aesirkth/Mjollnir_flightcontroller_v2/designs/flight_controller/main_controller2.kicad_pcb

## KiCad design designs/flight_controller/main_controller2.kicad_pcb (2023-04-16)

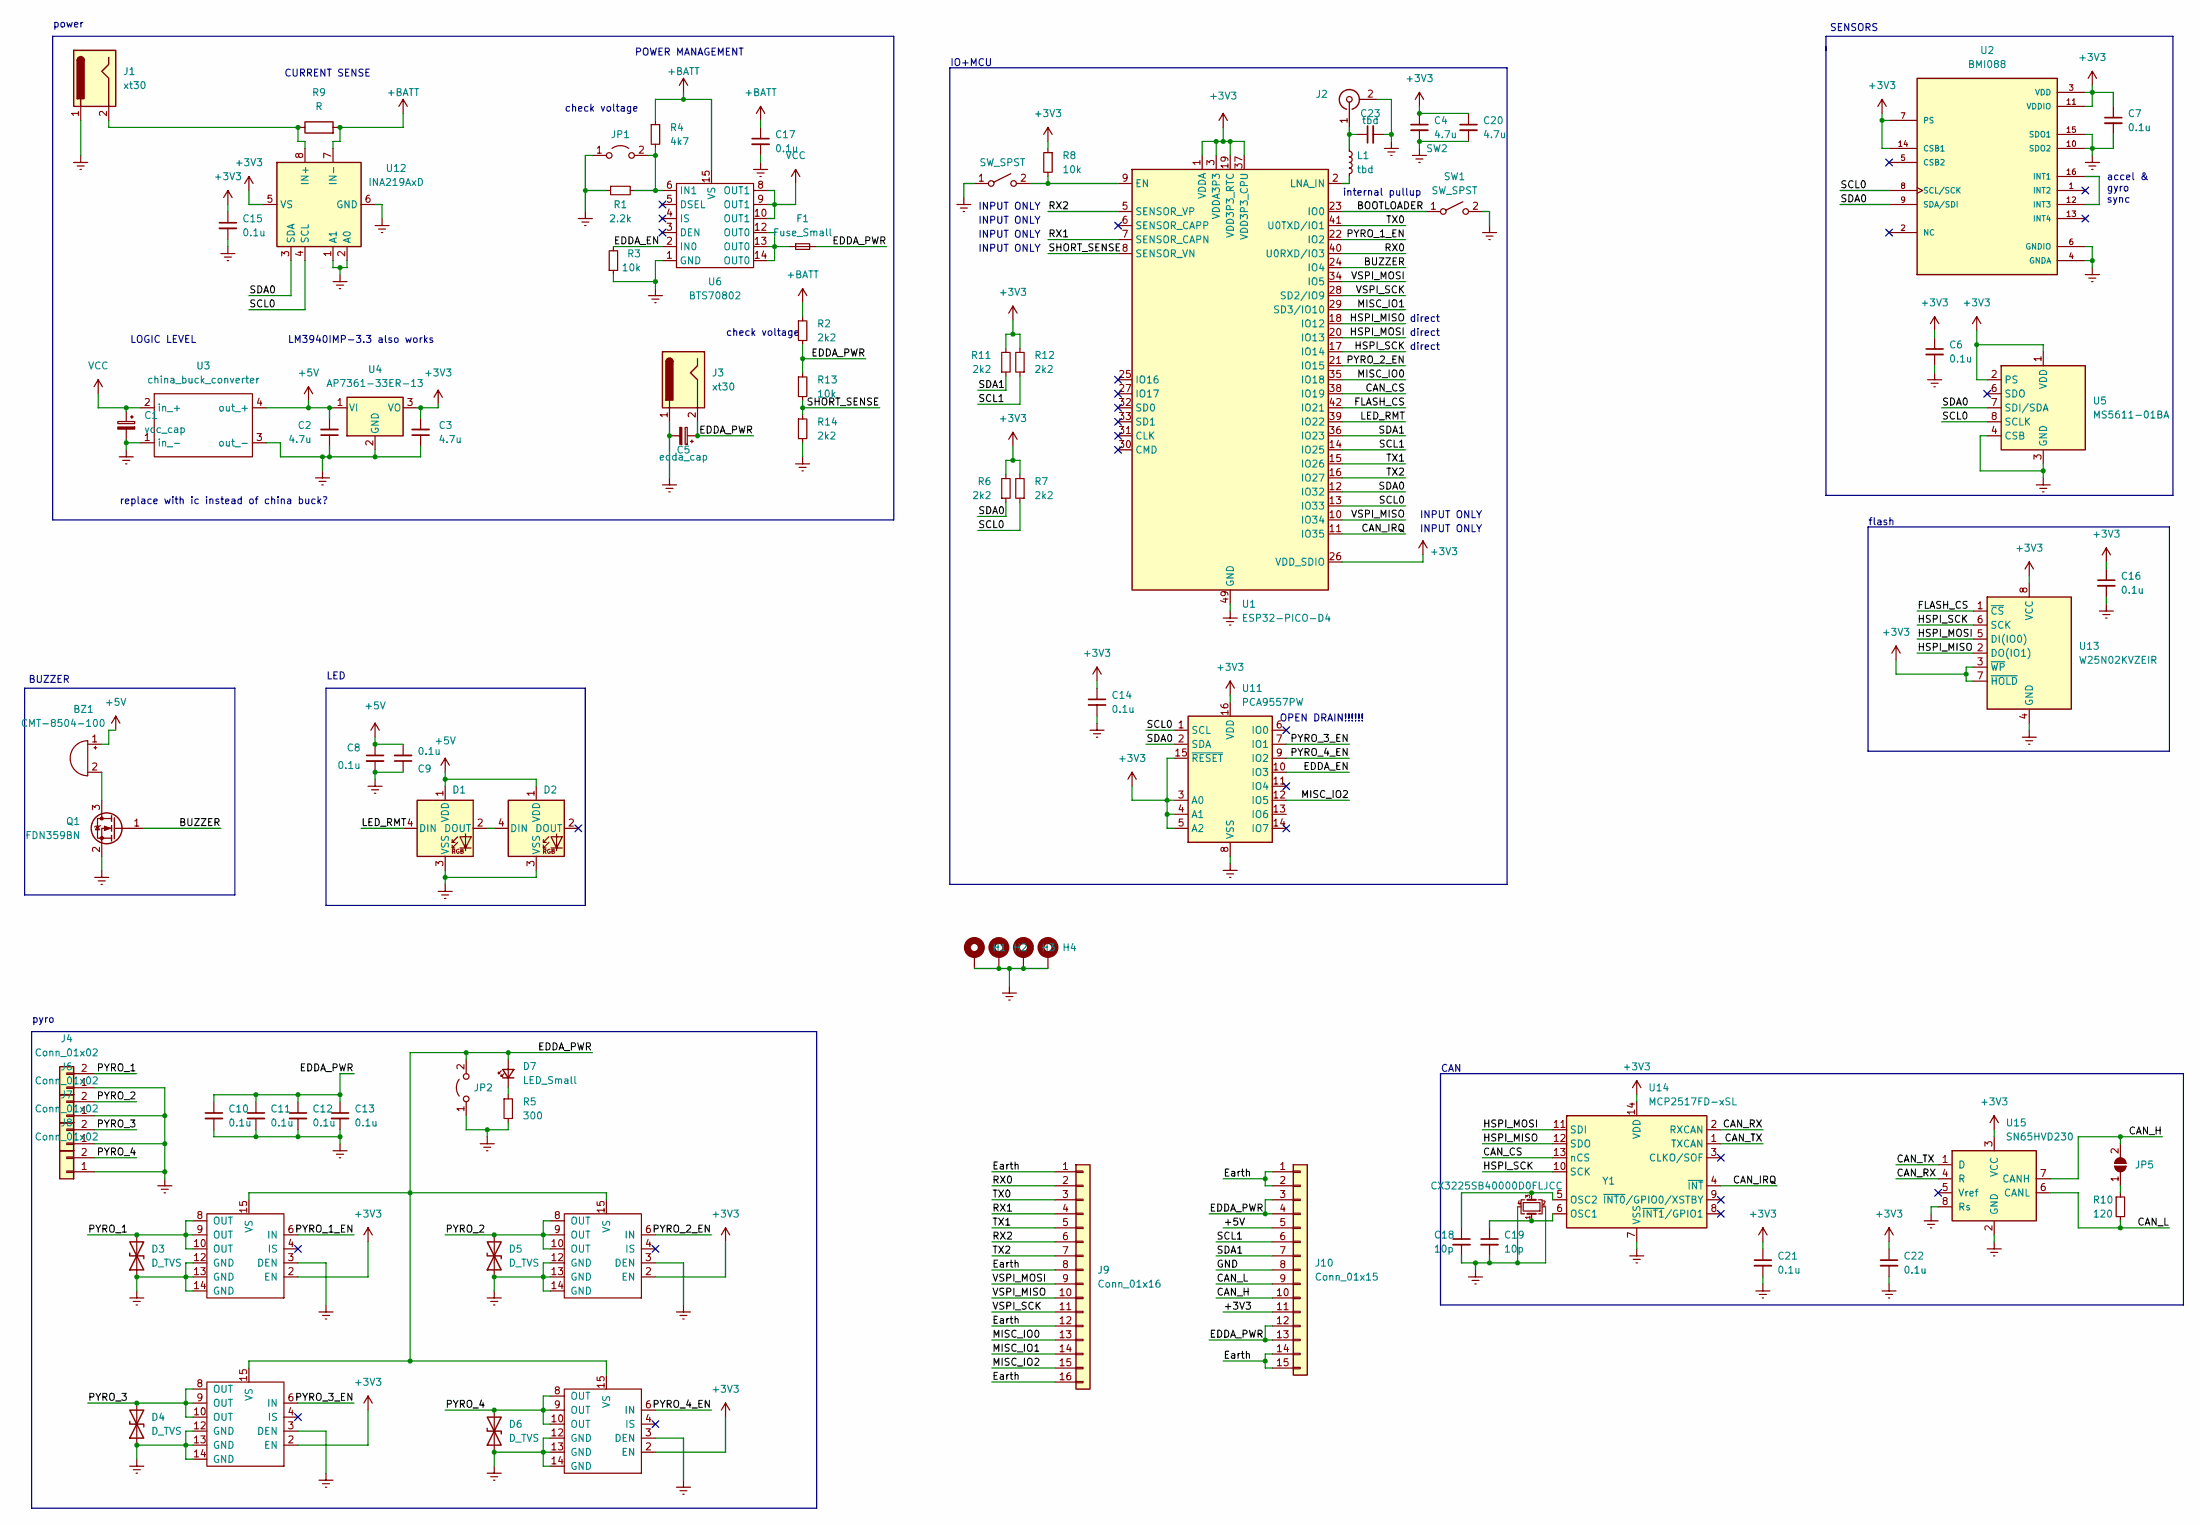
[picture p1: schematic main_controller2.kicad_sch]

Parts:
BZ1: CMT-8504-100; MagneticBuzzer_CUI_CMT-8504-100-SMT
C1: vcc_cap; CP_Radial_D5.0mm_P2.50mm
C2, C3, C4, C20: 4.7u; C_0603_1608Metric
C5: edda_cap; CP_Radial_D5.0mm_P2.50mm
C6, C7, C8, C9, C10, C11, C12, C13, C14, C15, C16, C17, C21, C22: 0.1u; C_0603_1608Metric
C18, C19: 10p; C_0603_1608Metric
C23: tbd; C_0603_1608Metric
D1, D2: WS2812B; LED_WS2812B_PLCC4_5.0x5.0mm_P3.2mm
D3, D4, D5, D6: D_TVS; D_0805_2012Metric
D7: LED_Small; D_0805_2012Metric
F1: Fuse_Small; Fuse_1812_4532Metric_Pad1.30x3.40mm_HandSolder
H1, H2, H3, H4: MountingHole_Pad; MountingHole_2.2mm_M2_Pad_Via
J1: xt30; AMASS_XT30PW-M_1x02_P2.50mm_Horizontal
J2: Conn_Coaxial; U.FL_Molex_MCRF_73412-0110_Vertical
J3: xt30; AMASS_XT30PW-F_1x02_P2.50mm_Horizontal
J4, J6, J7, J8: Conn_01x02; JST_XH_S2B-XH-A_1x02_P2.50mm_Horizontal
J9: Conn_01x16; PinHeader_1x16_P2.54mm_Vertical
J10: Conn_01x15; PinHeader_1x15_P2.54mm_Vertical
JP1: power switch; JST_XH_S2B-XH-A_1x02_P2.50mm_Horizontal
JP2: pyro_arm; AMASS_XT30PW-F_1x02_P2.50mm_Horizontal
JP5: SolderJumper_2_Open; SolderJumper-2_P1.3mm_Open_TrianglePad1.0x1.5mm
L1: tbd; L_0603_1608Metric
Q1: FDN359BN; SOT-23
R1: 2.2k; R_0603_1608Metric
R2, R6, R7, R11, R12, R14: 2k2; R_0603_1608Metric
R3, R8, R13: 10k; R_0603_1608Metric
R4: 4k7; R_0603_1608Metric
R5: 300; R_0603_1608Metric
R9: R; R_1206_3216Metric_Pad1.30x1.75mm_HandSolder
R10: 120; R_0603_1608Metric
SW1, SW2: SW_SPST; PinHeader_1x02_P1.27mm_Vertical
U1: ESP32-PICO-D4; QFN-48-1EP_7x7mm_P0.5mm_EP5.3x5.3mm
U2: BMI088; PQFN50P450X300X100-16N
U3: china_buck_converter; china_buck
U4: AP7361-33ER-13; SOT-223-3_TabPin2
U5: MS5611-01BA; LGA-8_3x5mm_P1.25mm
U6: BTS70802; Infineon_PG-TSDSO-14-22
U7, U8, U9, U10: BTN7030-1EPA; Infineon_PG-TSDSO-14-22
U11: PCA9557PW; TSSOP-16_4.4x5mm_P0.65mm
U12: INA219AxD; SOIC-8_3.9x4.9mm_P1.27mm
U13: W25N02KVZEIR; SON127P800X600X80-9N-D
U14: MCP2517FD-xSL; SOIC-14_3.9x8.7mm_P1.27mm
U15: SN65HVD230; SOIC-8_3.9x4.9mm_P1.27mm
Y1: CX3225SB40000D0FLJCC

Connections:
+3V3: C3.2, C4.1, C6.1, C7.1, C14.1, C15.1, C16.1, C20.1, C21.1, C22.1, J10.11, R6.2, R7.2, R8.1, R11.2, R12.2, U1.1 (VDDA), U1.3 (VDDA3P3), U1.4 (VDDA3P3), U1.19 (VDD3P3_RTC), U1.26 (VDD_SDIO), U1.37 (VDD3P3_CPU), U1.43 (VDDA), U1.46 (VDDA), U2.3 (VDD), U2.7 (PS), U2.11 (VDDIO), U2.14 (CSB1), U4.3 (VO), U5.1 (VDD), U5.2 (PS), U7.2 (EN), U8.2 (EN), U9.2 (EN), U10.2 (EN), U11.3 (A0), U11.4 (A1), U11.5 (A2), U11.15 (~RESET), U11.16 (VDD), U12.5 (VS), U13.3 (~WP), U13.7 (~HOLD), U13.8 (VCC), U14.14 (VDD), U15.3 (VCC)
+5V: BZ1.1 (-), C2.2, C8.1, C9.2, D1.1 (VDD), D2.1 (VDD), J10.5, U3.4 (out_+), U4.1 (VI)
+BATT: C17.1, R2.1, R4.1, R9.2, U6.15 (VS), U12.7 (IN-)
/BOOTLOADER: SW1.1 (A), U1.23 (IO0)
/BUZZER: Q1.1 (G), U1.24 (IO4)
/CAN_CS: U1.38 (IO19), U14.13 (nCS)
/CAN_H: J10.10, JP5.2 (B), U15.7 (CANH)
/CAN_IRQ: U1.11 (IO35), U14.4 (~INT)
/CAN_L: J10.9, R10.2, U15.6 (CANL)
/CAN_RX: U14.2 (RXCAN), U15.4 (R)
/CAN_TX: U14.1 (TXCAN), U15.1 (D)
/EDDA_EN: R3.2, U6.2 (IN0), U11.10 (IO3)
/EDDA_PWR: C5.1, C10.1, C11.1, C12.1, C13.1, D7.2 (A), F1.2, J3.2, J10.3, J10.4, J10.12, J10.13, JP2.2 (B), R2.2, R13.1, U7.15 (VS), U8.15 (VS), U9.15 (VS), U10.15 (VS)
/FLASH_CS: U1.42 (IO21), U13.1 (~CS)
/GND: J10.8
/HSPI_MISO: U1.18 (IO12), U13.2 (DO(IO1)), U14.12 (SDO)
/HSPI_MOSI: U1.20 (IO13), U13.5 (DI(IO0)), U14.11 (SDI)
/HSPI_SCK: U1.17 (IO14), U13.6 (SCK), U14.10 (SCK)
/LED_RMT: D1.4 (DIN), U1.39 (IO22)
/MISC_IO0: J9.13, U1.35 (IO18)
/MISC_IO1: J9.14, U1.29 (SD3/IO10)
/MISC_IO2: J9.15, U11.12 (IO5)
/PYRO_1: D3.2 (A2), J4.2, U7.8 (OUT), U7.9 (OUT), U7.10 (OUT)
/PYRO_1_EN: U1.22 (IO2), U7.6 (IN)
/PYRO_2: D5.2 (A2), J6.2, U9.8 (OUT), U9.9 (OUT), U9.10 (OUT)
/PYRO_2_EN: U1.21 (IO15), U9.6 (IN)
/PYRO_3: D4.2 (A2), J7.2, U8.8 (OUT), U8.9 (OUT), U8.10 (OUT)
/PYRO_3_EN: U8.6 (IN), U11.7 (IO1)
/PYRO_4: D6.2 (A2), J8.2, U10.8 (OUT), U10.9 (OUT), U10.10 (OUT)
/PYRO_4_EN: U10.6 (IN), U11.9 (IO2)
/RX0: J9.2, U1.40 (U0RXD/IO3)
/RX1: J9.4, U1.7 (SENSOR_CAPN)
/RX2: J9.6, U1.5 (SENSOR_VP)
/SCL0: R7.1, U1.13 (IO33), U2.8 (SCL/SCK), U5.8 (SCLK), U11.1 (SCL), U12.4 (SCL)
/SCL1: J10.6, R12.1, U1.14 (IO25)
/SDA0: R6.1, U1.12 (IO32), U2.9 (SDA/SDI), U5.7 (SDI/SDA), U11.2 (SDA), U12.3 (SDA)
/SDA1: J10.7, R11.1, U1.36 (IO23)
/SHORT_SENSE: R13.2, R14.1, U1.8 (SENSOR_VN)
/TX0: J9.3, U1.41 (U0TXD/IO1)
/TX1: J9.5, U1.15 (IO26)
/TX2: J9.7, U1.16 (IO27)
/VSPI_MISO: J9.10, U1.10 (IO34)
/VSPI_MOSI: J9.9, U1.34 (IO5)
/VSPI_SCK: J9.11, U1.28 (SD2/IO9)
Earth: C1.2, C2.1, C3.1, C4.2, C5.2, C6.2, C7.2, C8.2, C9.1, C10.2, C11.2, C12.2, C13.2, C14.2, C15.2, C16.2, C17.2, C18.2, C19.2, C20.2, C21.2, C22.2, C23.2, D1.3 (VSS), D2.3 (VSS), D3.1 (A1), D4.1 (A1), D5.1 (A1), D6.1 (A1), H1.1, H2.1, H3.1, H4.1, J1.1, J2.2 (Ext), J3.1, J4.1, J6.1, J7.1, J8.1, J9.1, J9.8, J9.12, J9.16, J10.1, J10.2, J10.14, J10.15, JP1.1 (A), JP2.1 (A), Q1.2 (S), R1.1, R3.1, R5.2, R14.2, SW1.2 (B), SW2.1 (A), U1.49 (GND), U2.4 (GNDA), U2.6 (GNDIO), U2.10 (SDO2), U2.15 (SDO1), U3.1 (in_-), U3.3 (out_-), U4.2 (GND), U5.3 (GND), U5.4 (CSB), U5.5 (CSB), U6.1 (GND), U7.3 (DEN), U7.12 (GND), U7.13 (GND), U7.14 (GND), U8.3 (DEN), U8.12 (GND), U8.13 (GND), U8.14 (GND), U9.3 (DEN), U9.12 (GND), U9.13 (GND), U9.14 (GND), U10.3 (DEN), U10.12 (GND), U10.13 (GND), U10.14 (GND), U11.8 (VSS), U12.1 (A1), U12.2 (A0), U12.6 (GND), U13.4 (GND), U14.7 (VSS), U15.2 (GND), U15.8 (Rs), Y1.2, Y1.4
unnamed: BZ1.2 (+), Q1.3 (D)
unnamed: C18.1, U14.5 (OSC2), Y1.3
unnamed: C19.1, U14.6 (OSC1), Y1.1
unnamed: C23.1, J2.1 (In), L1.1
unnamed: D1.2 (DOUT), D2.4 (DIN)
unnamed: D7.1 (K), R5.1
unnamed: F1.1, U6.12 (OUT0), U6.13 (OUT0), U6.14 (OUT0)
unnamed: J1.2, R9.1, U12.8 (IN+)
unnamed: JP1.2 (B), R1.2, R4.2, U6.6 (IN1)
unnamed: JP5.1 (A), R10.1
unnamed: L1.2, U1.2 (LNA_IN)
unnamed: R8.2, SW2.2 (B), U1.9 (EN)
unnamed: U2.12 (INT3), U2.16 (INT1)
VCC: C1.1, U3.2 (in_+), U6.8 (OUT1), U6.9 (OUT1), U6.10 (OUT1)

Notes on the sheet:
replace with ic instead of china buck?
direct
INPUT ONLY
IO+MCU
pyro
CURRENT SENSE
check voltage
BUZZER
flash
LOGIC LEVEL
LM3940IMP-3.3 also works
CAN
internal pullup
POWER MANAGEMENT
accel & gyro sync
LED
SENSORS
OPEN DRAIN!!!!!!
power

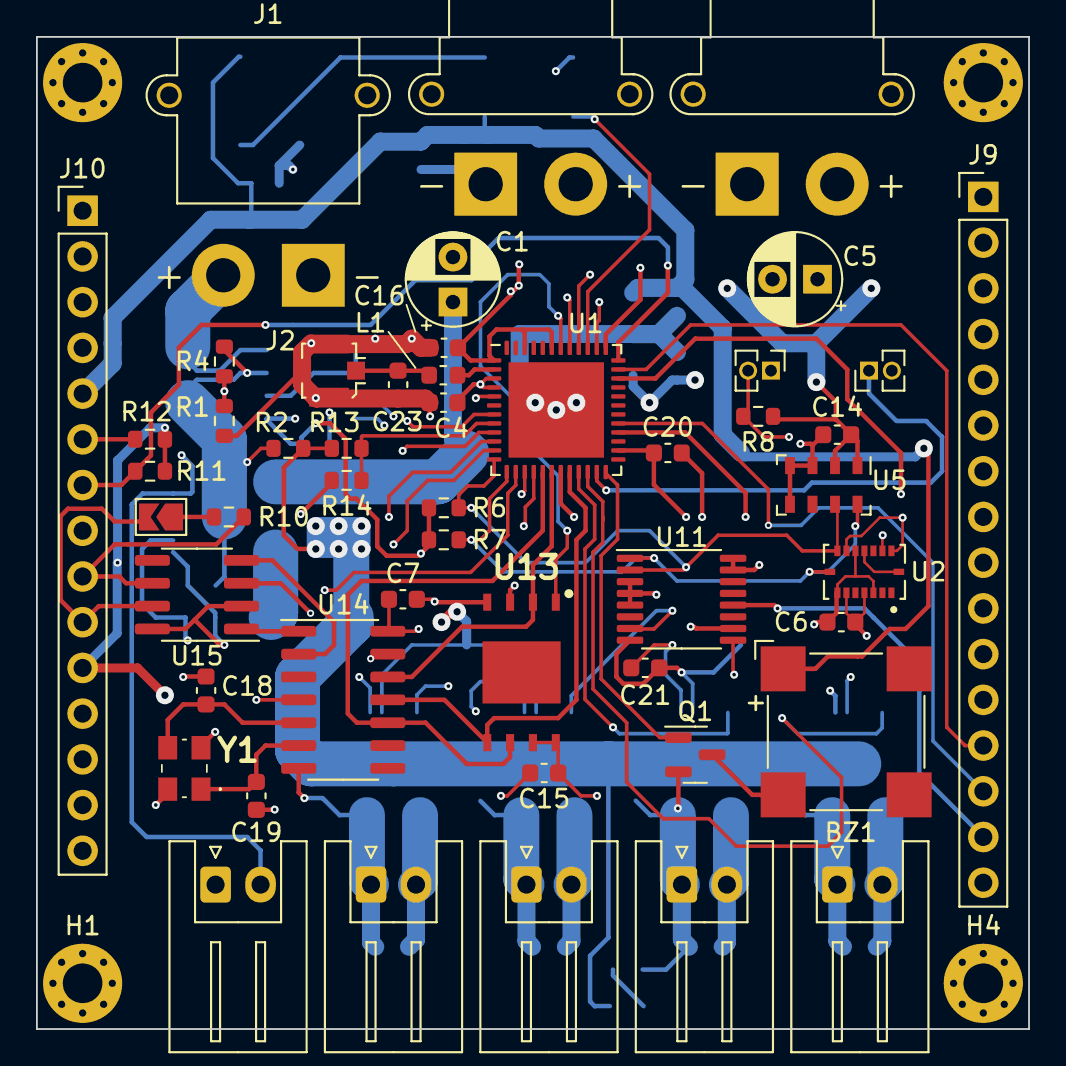
[picture p2: board main_controller2.kicad_pcb from above]

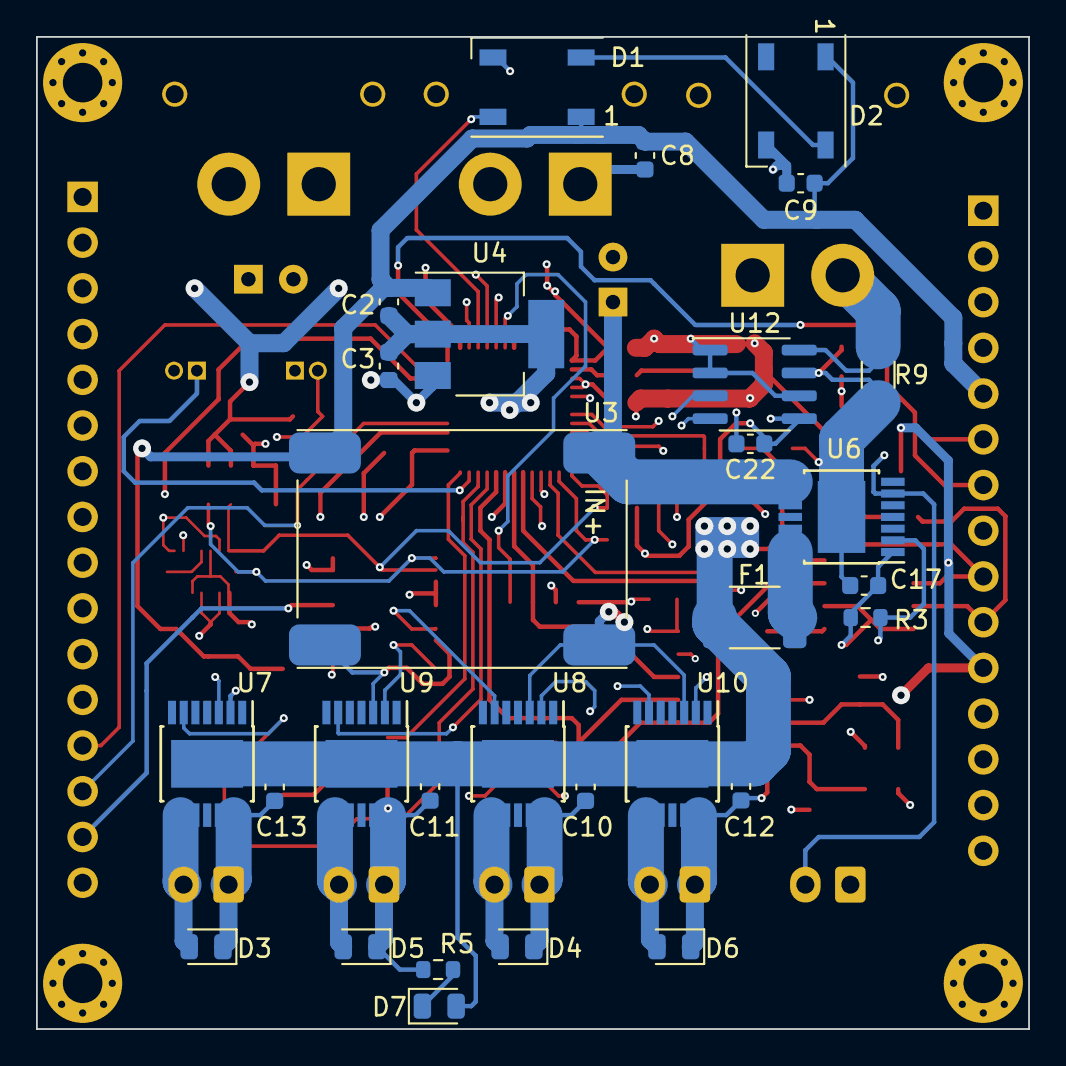
[picture p3: board main_controller2.kicad_pcb from below]

Board: 4 copper layers, 55.1 x 55.1 mm, 82 parts (29 on the bottom side), 58 nets.
