aesirkth/Mjollnir_flightcontroller_v2/(commit log)

2022-11-22 initial commit (the all in one board)
    [main_controller2.kicad_pcb, main_controller2.kicad_sch, main_controller2.sch]
2022-11-29 stackable version
    [main_controller2.kicad_pcb, main_controller2.kicad_sch]
2023-01-19 move to esp pico
    [main_controller2.kicad_pcb, main_controller2.kicad_sch]
2023-01-19 better structure
    [main_controller2.kicad_pcb, main_controller2.kicad_sch, main_controller2.sch]
2023-01-24 fix grid
    [main_controller2.kicad_sch]
2023-01-24 preliminary layout
    [main_controller2.kicad_pcb, main_controller2.kicad_sch]
2023-01-25 add ufl
    [main_controller2.kicad_pcb, main_controller2.kicad_sch]
2023-02-22 routing done
    [main_controller2.kicad_pcb, main_controller2.kicad_sch]
2023-04-16 final design
    [main_controller2.kicad_pcb, main_controller2.kicad_sch]
